joyontadebnath/Water-Quality-Monitoring-and-Automated-Fish-Feeder-System/images/methodology.png

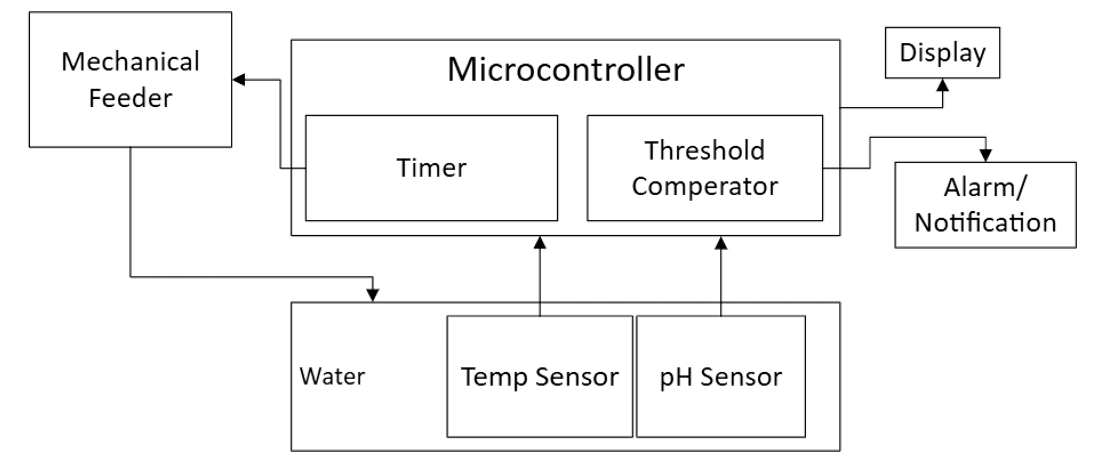
images/methodology.png
